lzptr/solar-controller/enclosure/renders/cutaway.png

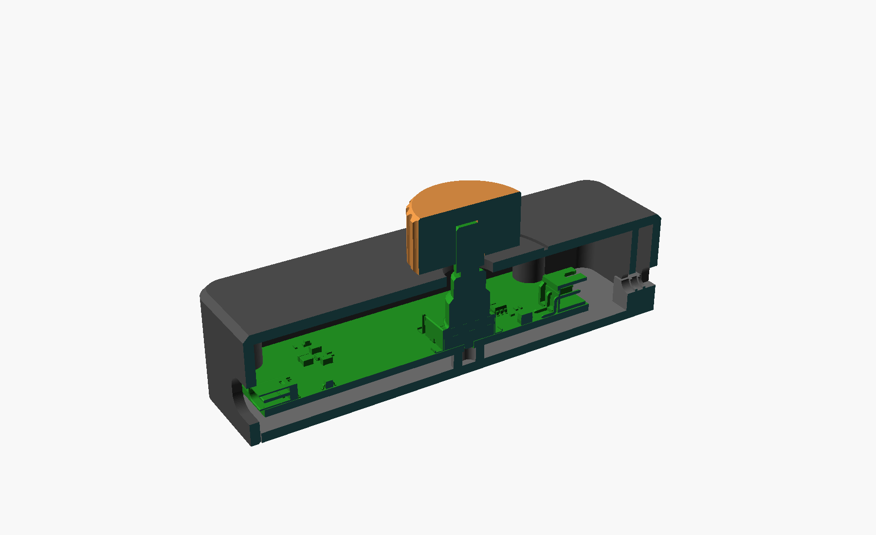
enclosure/renders/cutaway.png
