lzptr/solar-controller/enclosure/renders/exploded.png

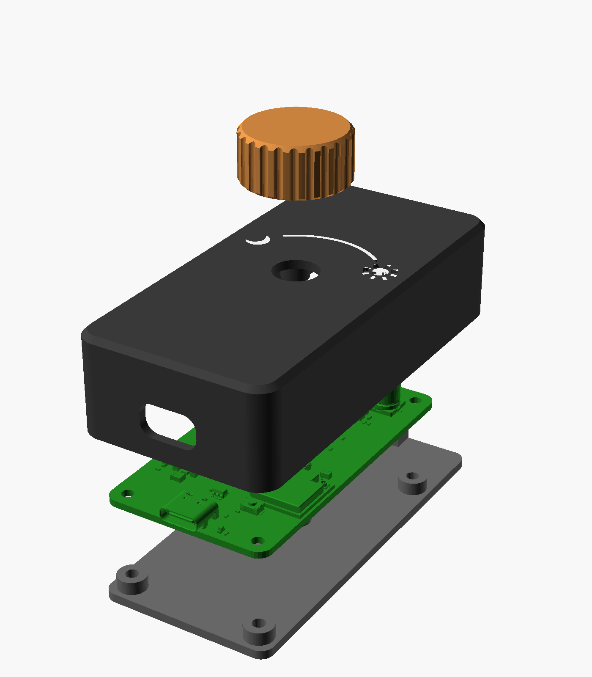
enclosure/renders/exploded.png
