lzptr/solar-controller/enclosure/renders/h103_post_neck.png

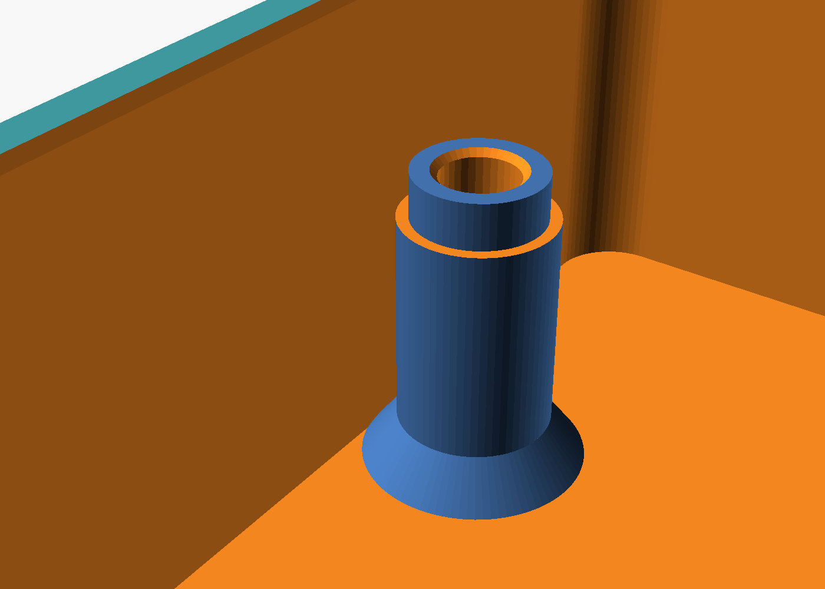
enclosure/renders/h103_post_neck.png
