lzptr/solar-controller/enclosure/renders/lid_top.png

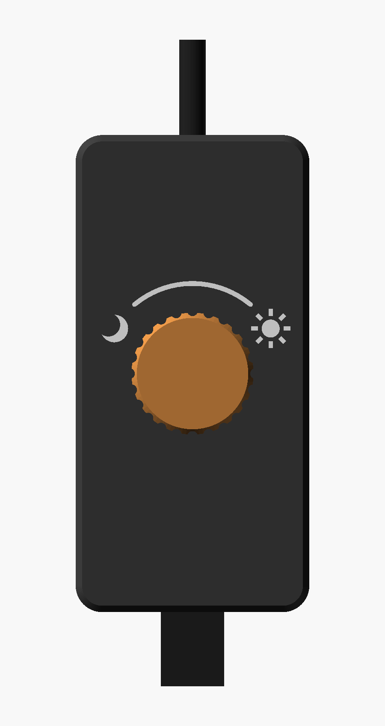
enclosure/renders/lid_top.png
