lzptr/solar-controller/globe_socket/renders/cutaway_iso.png

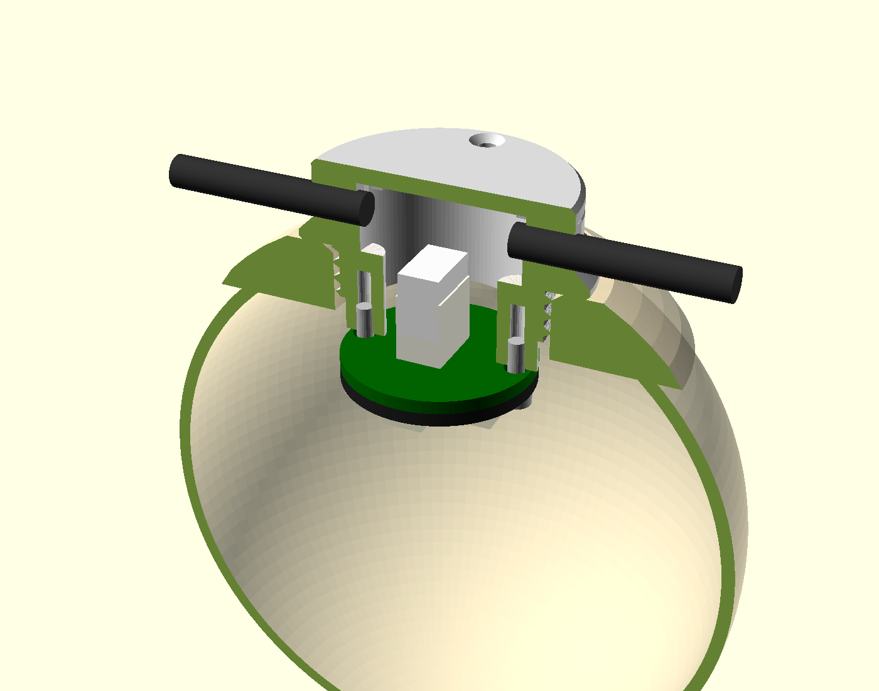
globe_socket/renders/cutaway_iso.png
