lzptr/solar-controller/globe_socket/renders/exploded.png

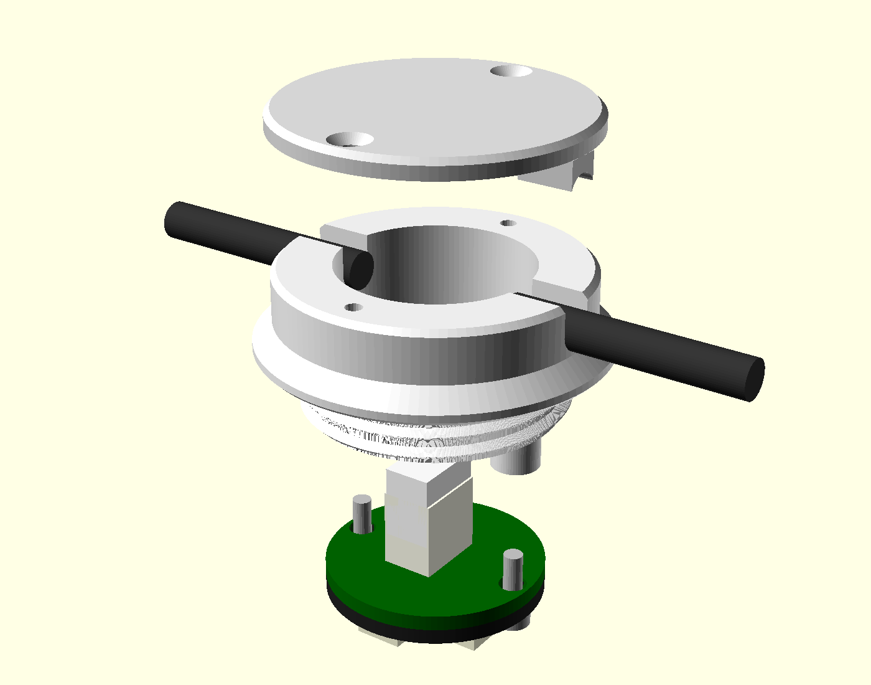
globe_socket/renders/exploded.png
