lzptr/solar-controller/hardware/led_adapter/renders/bottom.png

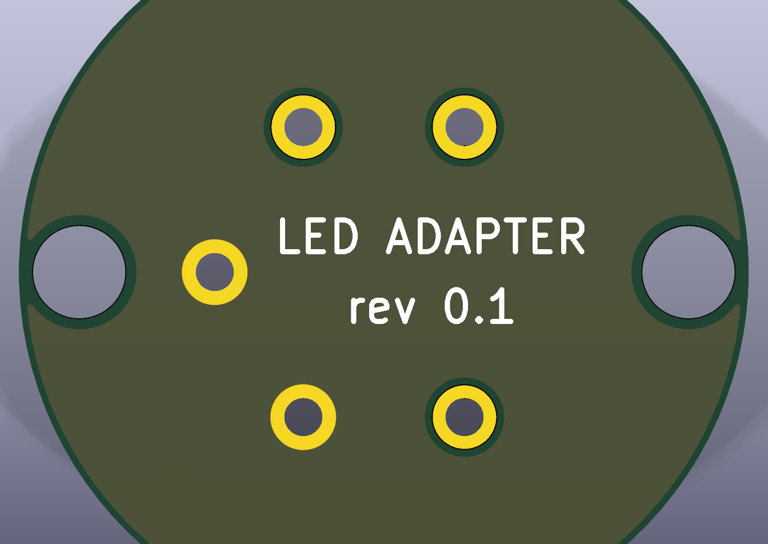
hardware/led_adapter/renders/bottom.png
