lzptr/solar-controller/hardware/led_adapter/renders/top.png

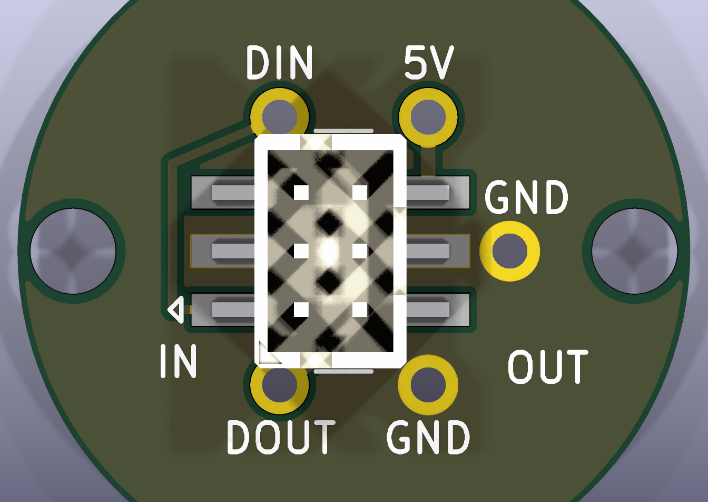
hardware/led_adapter/renders/top.png
