lzptr/solar-controller/hardware/solar_controller/renders/bottom.png

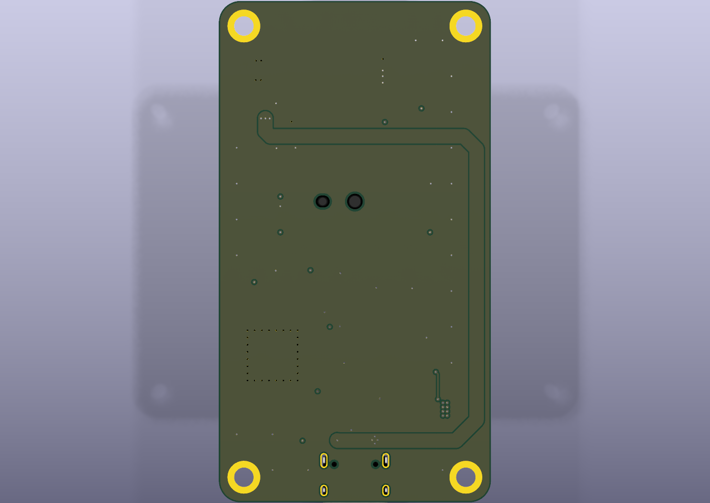
hardware/solar_controller/renders/bottom.png
