lzptr/solar-controller/hardware/solar_controller/renders/top.png

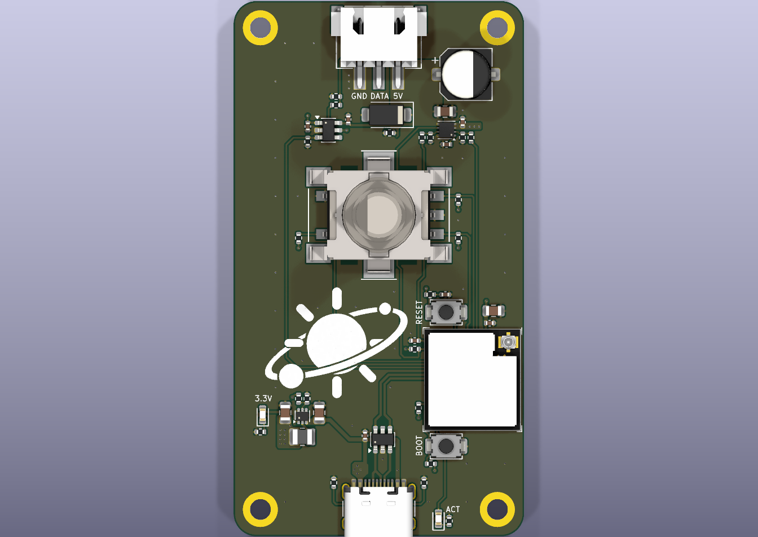
hardware/solar_controller/renders/top.png
