lzptr/solar-controller/hardware/production/bom.csv

Designator | Footprint | Quantity | Value | LCSC Part #
C205 | 0805 | 1 | 4u7 | C1779
C206, C303, C405 | 0805 | 3 | 22u | C45783
C301 | 0402 | 1 | 1u | C14445
C302, C304, C401, C402, C403, C407, C408 | 0402 | 7 | 100n | C1525
C404 | CP_Elec_6.3x7.7 | 1 | 470u | C46550459
D201 | 0603 | 1 | LED_GREEN | C965804
D301 | 0603 | 1 | LED_ACT | C965804
D401 | D_SMA | 1 | SS34 | C8678
J301 | USB_C_Receptacle_HRO_TYPE-C-31-M-12 | 1 | USB_C_Receptacle_USB2.0 | C165948
J401 | Megastar_ZX-XH2.54-3PWT | 1 | ZX-XH2.54-3PWT | C7429672
L201 | 1008 | 1 | 1u | C435392
R208, R407, R410, R414 | 0402 | 4 | 100k | C25741
R209 | 0402 | 1 | 22k | C25768
R211, R306, R405, R406, R411, R412 | 0402 | 6 | 2k2 | C25879
R301, R302, R303, R404, R408, R413 | 0402 | 6 | 10k | C25744
R307, R308 | 0402 | 2 | 5k1 | C25905
R403 | 0402 | 1 | 1k | C11702
R409 | 0402 | 1 | 330 | C25104
SW301 | SW_SPST_TS-1088-xR020 | 1 | RESET | C720477
SW302 | SW_SPST_TS-1088-xR020 | 1 | BOOT | C720477
SW402 | ALPS_EC11J1525402 | 1 | EC11J1525402 | C209762
U203 | SOT-563 | 1 | TPS62A01ADRL | C5181455
U301 | ESP32-C6-MINI-1U | 1 | ESP32-C6-MINI-1U-H4 | C20627095
U302 | SOT-23-6 | 1 | USBLC6-2SC6 | C5261088
U402 | Texas_DSG0008A_WSON-8-1EP_2x2mm_P0.5mm_EP0.9x1.6mm | 1 | TPS259531DSGR | C2155674
U403 | SOT-23-6 | 1 | SN74LVC1T45DBVR | C7843
