lzptr/solar-controller/hardware/led_adapter/production/bom.csv

Designator | Footprint | Quantity | Value | LCSC Part #
J1 | Hanxia_HX-PHD2.0-2x3ALT | 1 | HX-PHD2.0-2x3ALT | C53055815
