lzptr/solar-controller/enclosure/ref/assembly_check.3mf

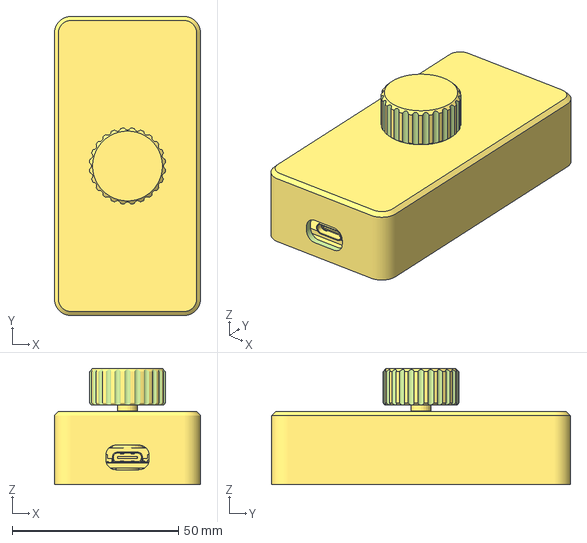
[picture p12: CAD file, 2026-10-16]
enclosure/ref/assembly_check.3mf
44.0 x 90.0 x 35.0 mm
