lzptr/solar-controller/enclosure/ref/pcb.stl

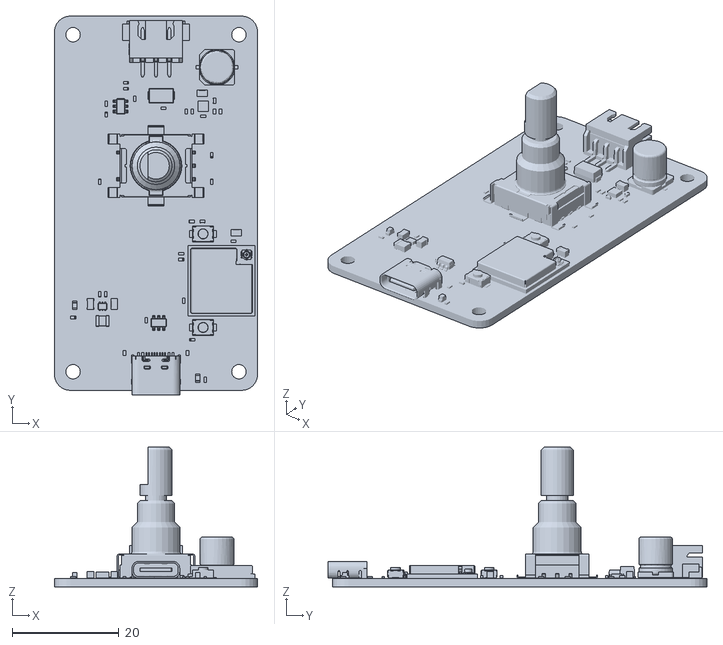
[picture p13: CAD file, 2026-10-16]
enclosure/ref/pcb.stl
38.0 x 70.8 x 26.1
