lzptr/solar-controller/enclosure/solar_controller_enclosure.3mf

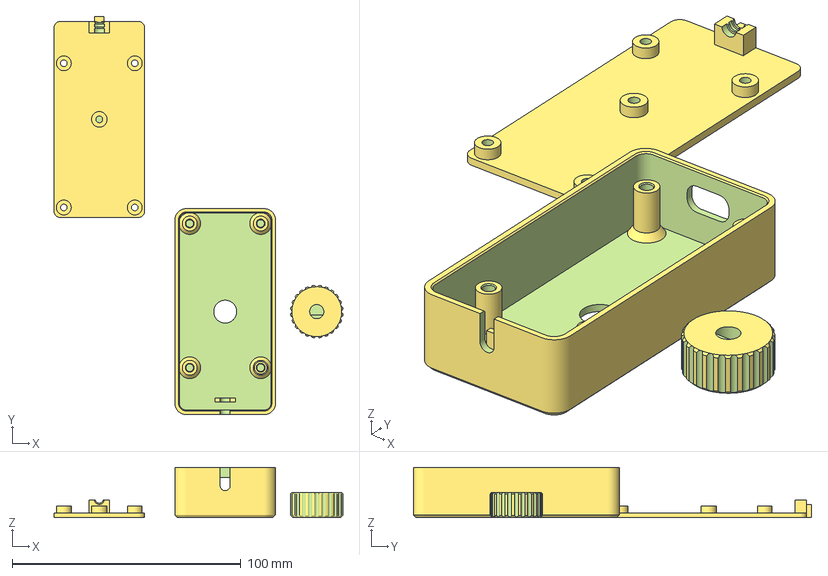
[picture p14: CAD file, 2026-10-16]
enclosure/solar_controller_enclosure.3mf
126.3 x 174.0 x 22.0 mm
base_plate
top_shell
knob
