lzptr/solar-controller/enclosure/stl/knob.stl

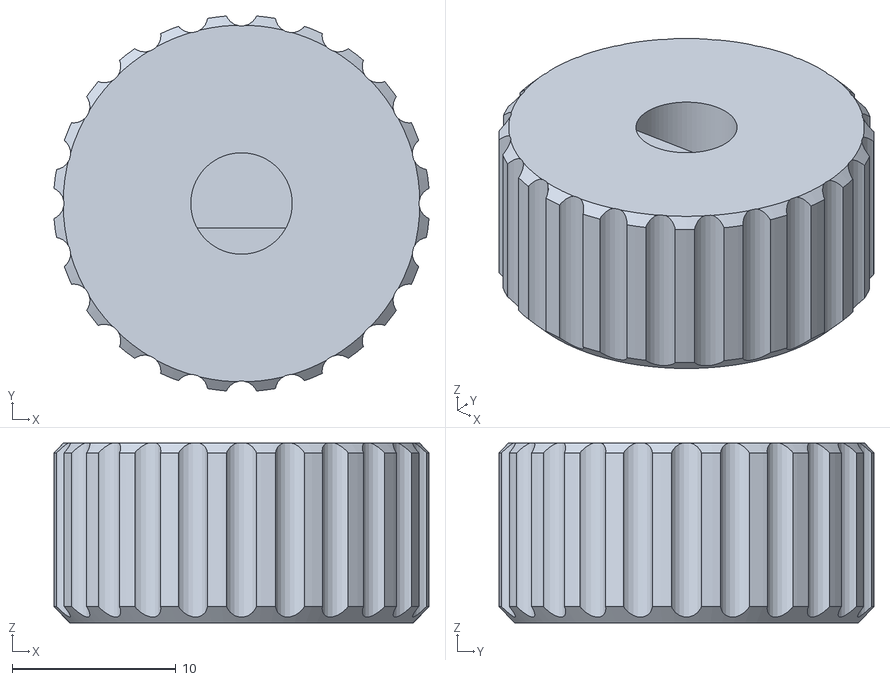
[picture p15: CAD file, 2026-10-16]
enclosure/stl/knob.stl
22.9 x 22.9 x 11.0
