lzptr/solar-controller/globe_socket/stl/socket_body.stl

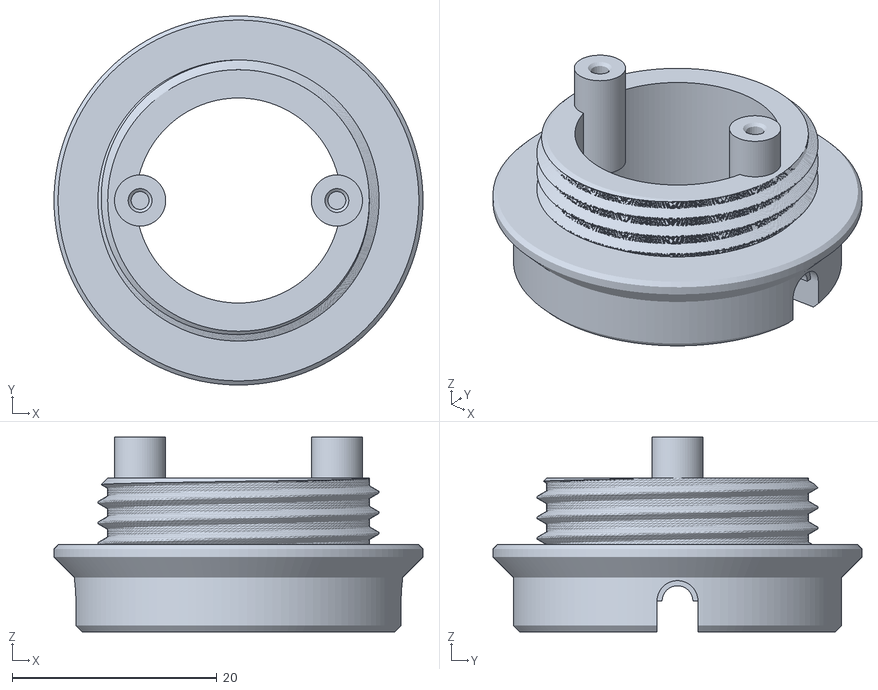
[picture p16: CAD file, 2026-10-22]
globe_socket/stl/socket_body.stl
36.0 x 36.0 x 19.0
