lzptr/solar-controller/enclosure/stl/base_plate.stl

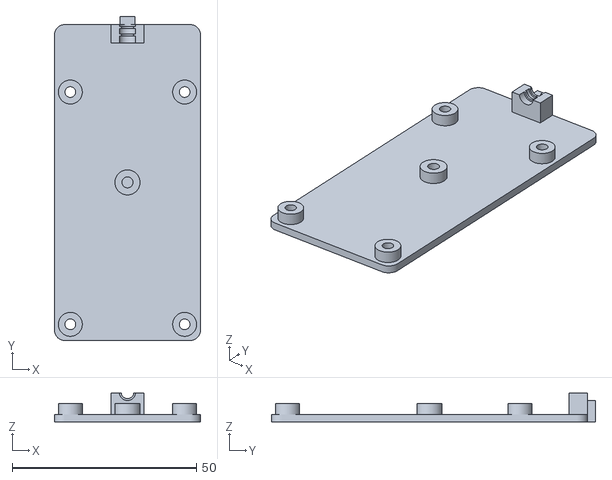
[picture p17: CAD file, 2026-10-16]
enclosure/stl/base_plate.stl
39.6 x 87.9 x 7.80
