lzptr/solar-controller/globe_socket/stl/socket_cap.stl

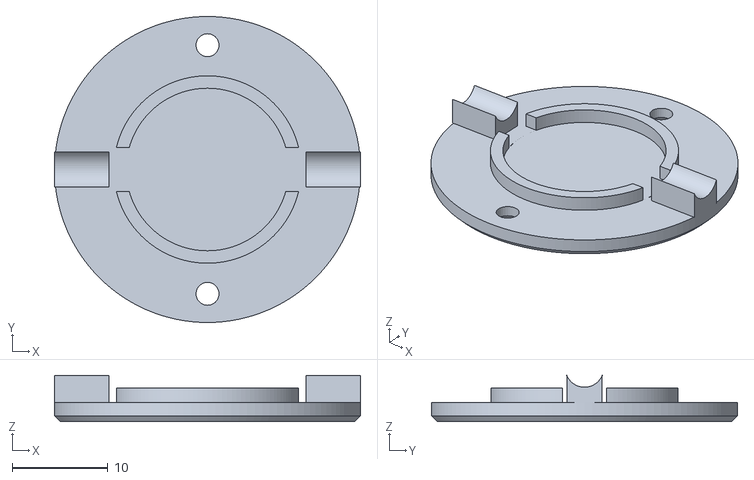
[picture p18: CAD file, 2026-10-22]
globe_socket/stl/socket_cap.stl
32.0 x 32.0 x 4.84
