lzptr/solar-controller/enclosure/stl/artwork_inlay.stl

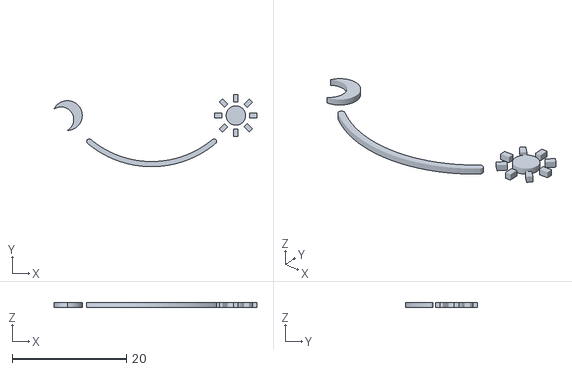
[picture p19: CAD file, 2026-10-16]
enclosure/stl/artwork_inlay.stl
35.5 x 12.6 x 0.8
