lzptr/solar-controller/enclosure/stl/top_shell.stl

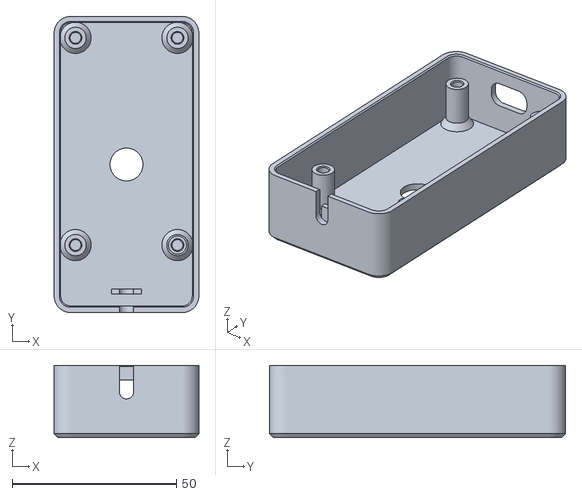
[picture p20: CAD file, 2026-10-16]
enclosure/stl/top_shell.stl
44.0 x 90.0 x 22.0
