lzptr/solar-controller/enclosure/renders/print_layout.png

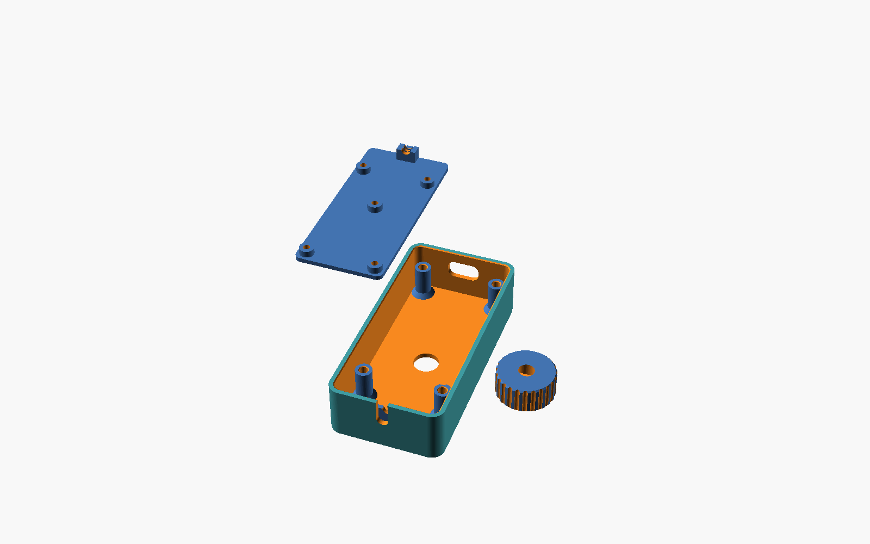
enclosure/renders/print_layout.png
