lzptr/solar-controller/globe_socket/renders/print_layout.png

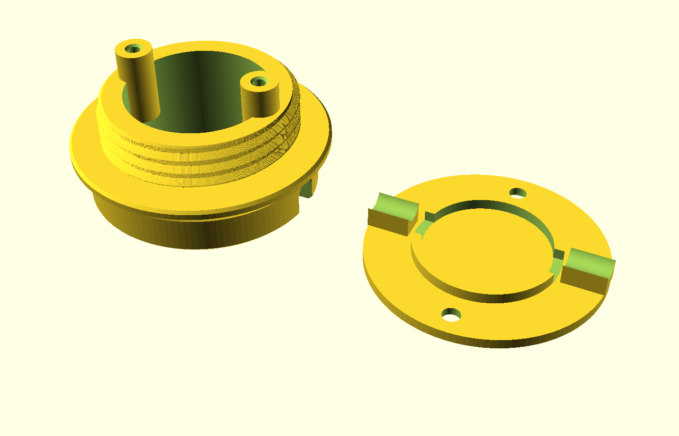
globe_socket/renders/print_layout.png
