lzptr/solar-controller/hardware/solar-controller.kicad_pcb

## KiCad design hardware/solar-controller.kicad_pcb (2026-10-15)

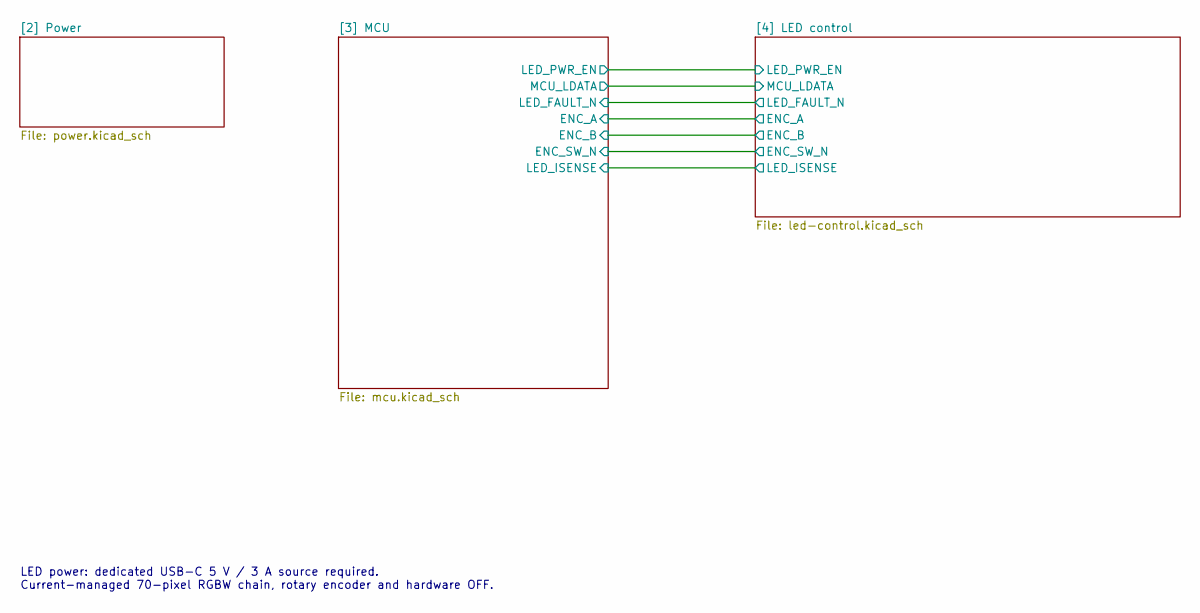
[picture p23: schematic solar-controller.kicad_sch, LED power and controls]

Notes on the sheet:
LED power: dedicated USB-C 5 V / 3 A source required. Current-managed 70-pixel RGBW chain, rotary encoder and hardware OFF.

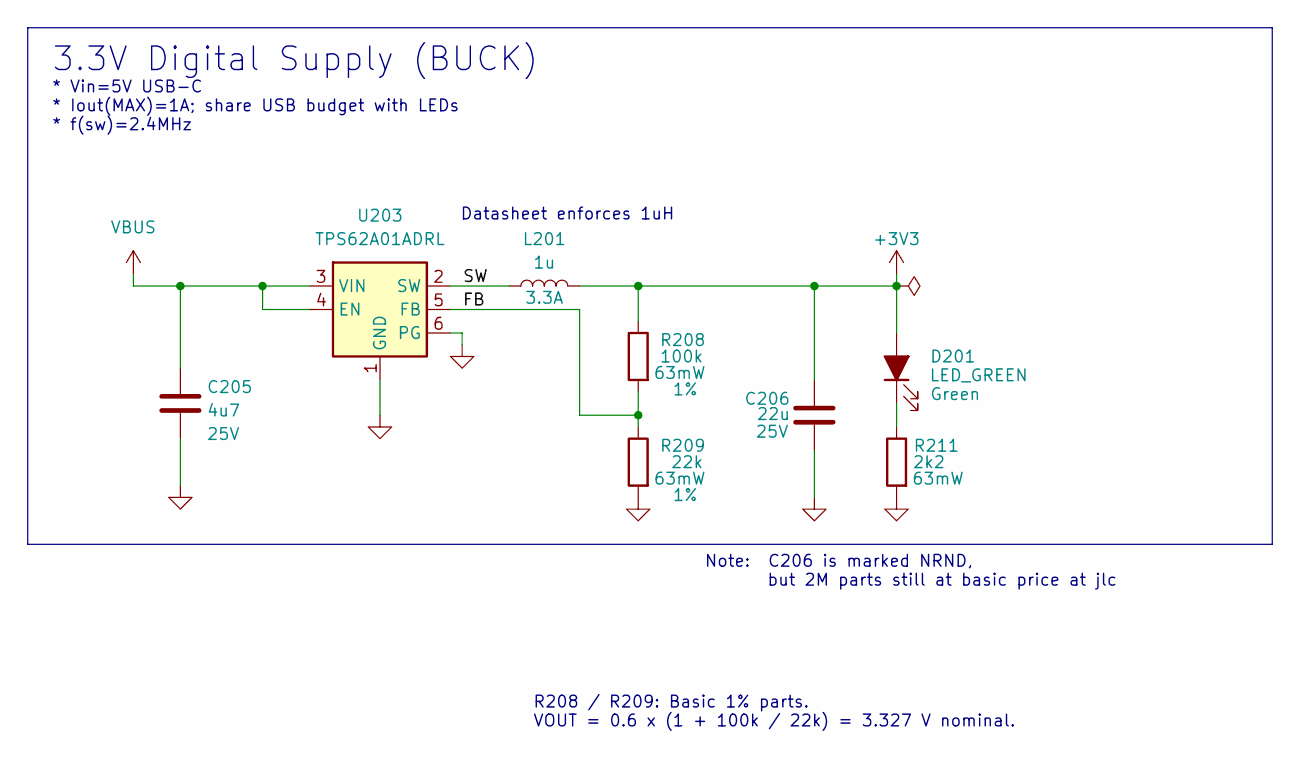
[picture p24: schematic power.kicad_sch, LED power and controls]

Parts:
C205: 4u7; C_0805_2012Metric; Rating 25V; LCSC Part # C1779
C206: 22u; C_0805_2012Metric; Rating 25V; LCSC Part # C45783
D201: LED_GREEN; LED_0603_1608Metric; Rating Green; LCSC Part # C965804
L201: 1u; L_1008_2520Metric; Rating 3.3A; LCSC Part # C435392
R208: 100k; R_0402_1005Metric; Rating 63mW; LCSC Part # C25741
R209: 22k; R_0402_1005Metric; Rating 63mW; LCSC Part # C25768
R211: 2k2; R_0402_1005Metric; Rating 63mW; LCSC Part # C25879
U203: TPS62A01ADRL; SOT-563; LCSC Part # C5181455

Connections:
+3V3: C206.1, D201.2 (A), L201.2, R208.1; also elsewhere on the board
/[2] Power/FB: R208.2, R209.1, U203.5 (FB)
/[2] Power/SW: L201.1, U203.2 (SW)
GND: C205.2, C206.2, R209.2, R211.2, U203.1 (GND), U203.6 (PG); also elsewhere on the board
unnamed: D201.1 (K), R211.1
VBUS: C205.1, U203.3 (VIN), U203.4 (EN); also elsewhere on the board

Notes on the sheet:
* Vin=5V USB-C * Iout(MAX)=1A; share USB budget with LEDs * f(sw)=2.4MHz
Datasheet enforces 1uH
Note: C206 is marked NRND, but 2M parts still at basic price at jlc
3.3V Digital Supply (BUCK)
R208 / R209: Basic 1% parts. VOUT = 0.6 x (1 + 100k / 22k) = 3.327 V nominal.

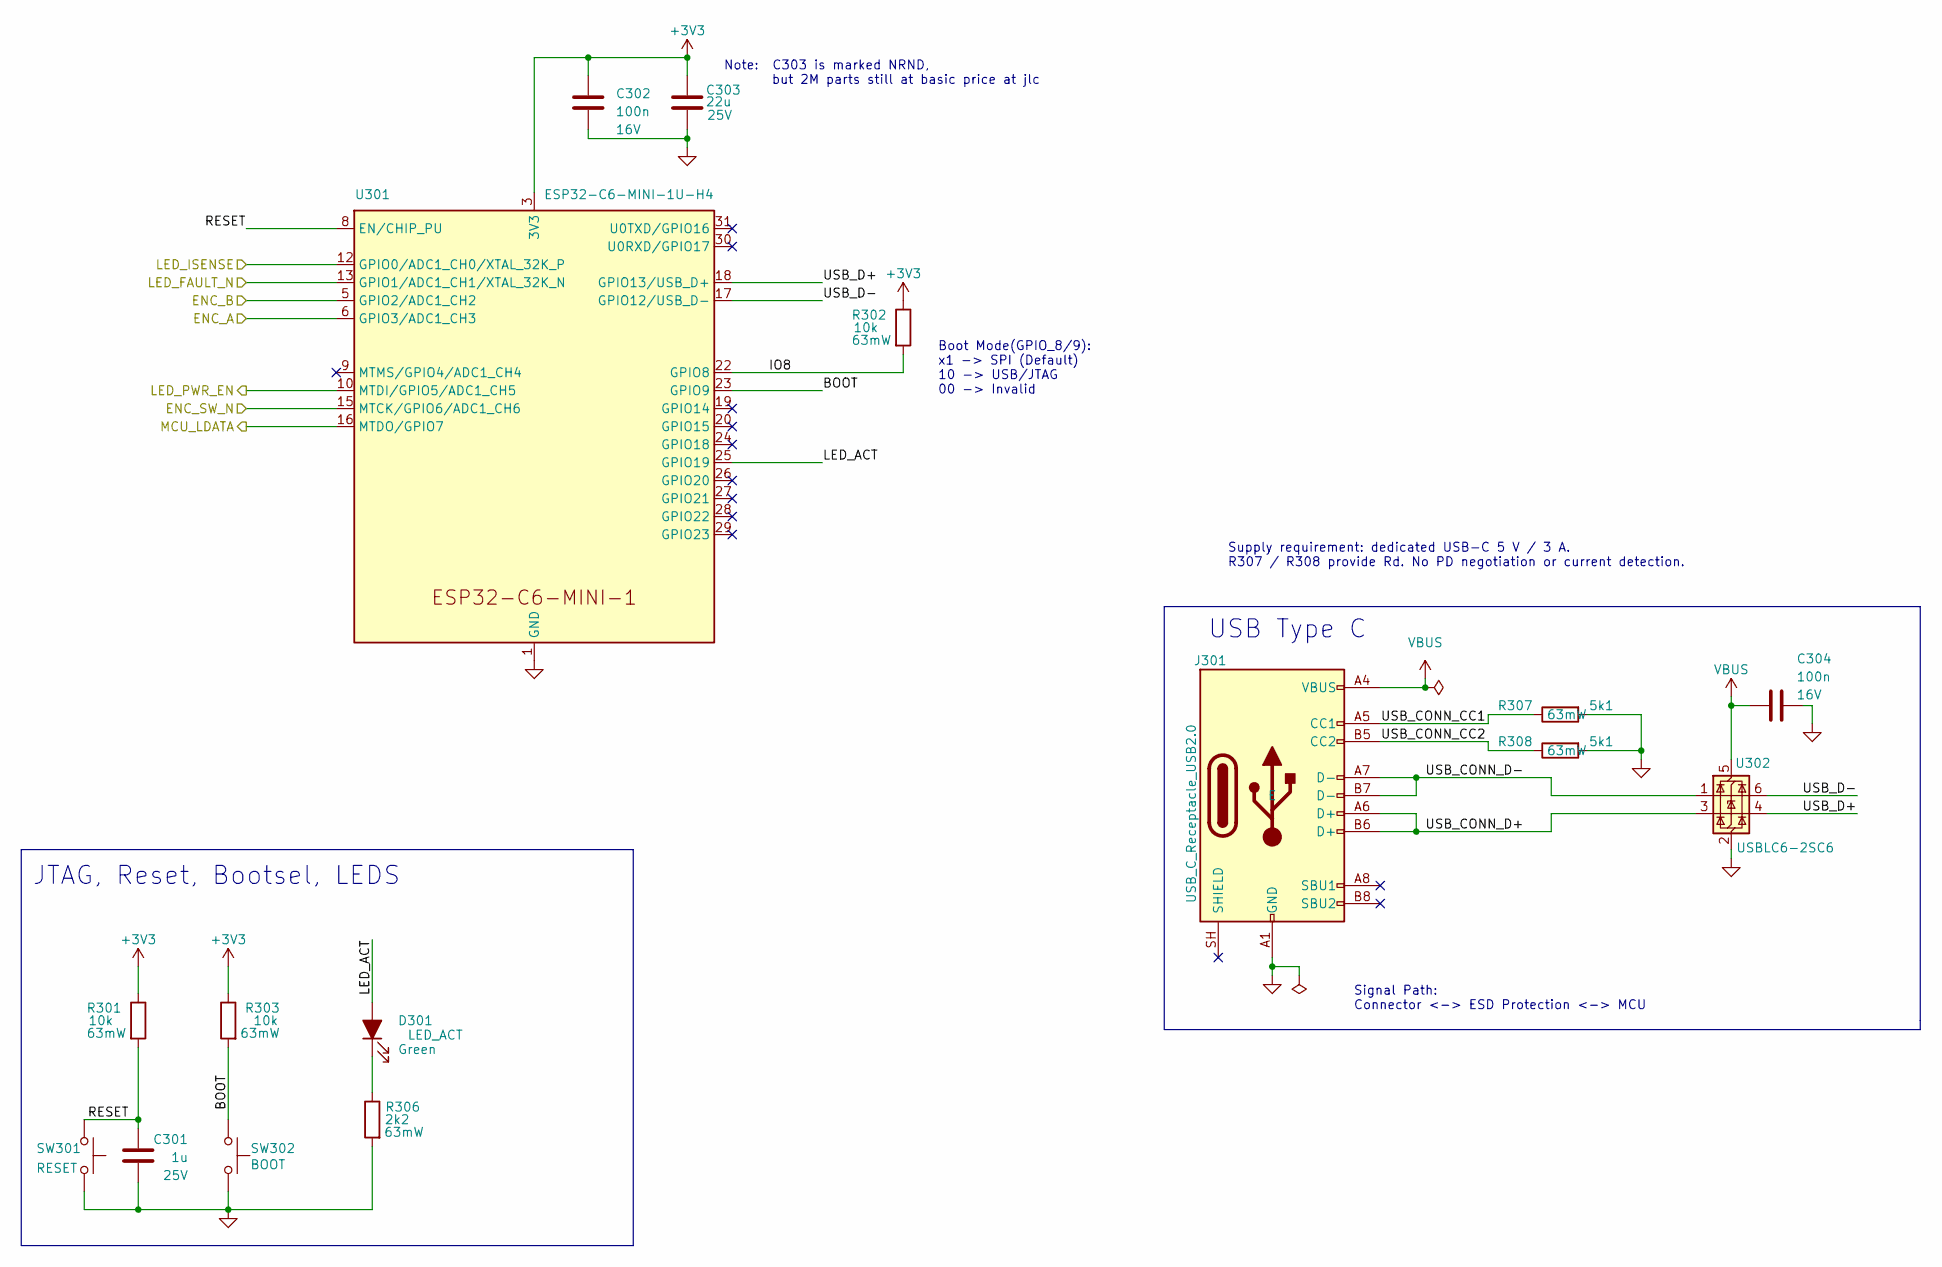
[picture p25: schematic mcu.kicad_sch, LED power and controls]

Parts:
C301: 1u; C_0402_1005Metric; Rating 25V; LCSC Part # C52923
C302, C304: 100n; C_0402_1005Metric; Rating 16V; LCSC Part # C1525
C303: 22u; C_0805_2012Metric; Rating 25V; LCSC Part # C45783
D301: LED_ACT; LED_0603_1608Metric; Rating Green; LCSC Part # C2994781
J301: USB_C_Receptacle_USB2.0; USB_C_Receptacle_HRO_TYPE-C-31-M-12; LCSC Part # C165948
R301, R302, R303: 10k; R_0402_1005Metric; Rating 63mW; LCSC Part # C25744
R306: 2k2; R_0402_1005Metric; Rating 63mW; LCSC Part # C25879
R307, R308: 5k1; R_0402_1005Metric; Rating 63mW; LCSC Part # C25905
SW301: RESET; SW_SPST_TS-1088-xR020; LCSC Part # C720477
SW302: BOOT; SW_SPST_TS-1088-xR020; LCSC Part # C720477
U301: ESP32-C6-MINI-1U-H4; ESP32-C6-MINI-1U; LCSC Part # C20627095
U302: USBLC6-2SC6; SOT-23-6; LCSC Part # C5261088

Connections:
+3V3: C302.1, C303.1, R301.1, R302.1, R303.1, U301.3 (3V3); also elsewhere on the board
/[3] MCU/BOOT: R303.2, SW302.1, U301.23 (GPIO9)
/[3] MCU/ENC_A: U301.6 (GPIO3/ADC1_CH3); also elsewhere on the board
/[3] MCU/ENC_B: U301.5 (GPIO2/ADC1_CH2); also elsewhere on the board
/[3] MCU/ENC_SW_N: U301.15 (MTCK/GPIO6/ADC1_CH6); also elsewhere on the board
/[3] MCU/IO8: R302.2, U301.22 (GPIO8)
/[3] MCU/LED_ACT: D301.2 (A), U301.25 (GPIO19)
/[3] MCU/LED_FAULT_N: U301.13 (GPIO1/ADC1_CH1/XTAL_32K_N); also elsewhere on the board
/[3] MCU/LED_ISENSE: U301.12 (GPIO0/ADC1_CH0/XTAL_32K_P); also elsewhere on the board
/[3] MCU/LED_PWR_EN: U301.10 (MTDI/GPIO5/ADC1_CH5); also elsewhere on the board
/[3] MCU/MCU_LDATA: U301.16 (MTDO/GPIO7); also elsewhere on the board
/[3] MCU/RESET: C301.1, R301.2, SW301.1, U301.8 (EN/CHIP_PU)
/[3] MCU/USB_CONN_CC1: J301.A5 (CC1), R307.1
/[3] MCU/USB_CONN_CC2: J301.B5 (CC2), R308.1
/[3] MCU/USB_CONN_D+: J301.A6 (D+), J301.B6 (D+), U302.3 (I/O2)
/[3] MCU/USB_CONN_D-: J301.A7 (D-), J301.B7 (D-), U302.1 (I/O1)
/[3] MCU/USB_D+: U301.18 (GPIO13/USB_D+), U302.4 (I/O2)
/[3] MCU/USB_D-: U301.17 (GPIO12/USB_D-), U302.6 (I/O1)
GND: C301.2, C302.2, C303.2, C304.2, J301.A1 (GND), J301.A12 (GND), J301.B1 (GND), J301.B12 (GND), R306.2, R307.2, R308.2, SW301.2, SW302.2, U301.1 (GND), U301.2 (GND), U301.11 (GND), U301.14 (GND), U301.36 (GND), U301.37 (GND), U301.38 (GND), U301.39 (GND), U301.40 (GND), U301.41 (GND), U301.42 (GND), U301.43 (GND), U301.44 (GND), U301.45 (GND), U301.46 (GND), U301.47 (GND), U301.48 (GND), U301.49 (GND), U301.50 (GND), U301.51 (GND), U301.52 (GND), U301.53 (GND), U302.2 (GND); also elsewhere on the board
unnamed: D301.1 (K), R306.1
VBUS: C304.1, J301.A4 (VBUS), J301.A9 (VBUS), J301.B4 (VBUS), J301.B9 (VBUS), U302.5 (VBUS); also elsewhere on the board

Notes on the sheet:
Signal Path: Connector <-> ESD Protection <-> MCU
Note: C303 is marked NRND, but 2M parts still at basic price at jlc
Boot Mode(GPIO_8/9): x1 -> SPI (Default) 10 -> USB/JTAG 00 -> Invalid
USB Type C
Supply requirement: dedicated USB-C 5 V / 3 A. R307 / R308 provide Rd. No PD negotiation or current detection.
JTAG, Reset, Bootsel, LEDS

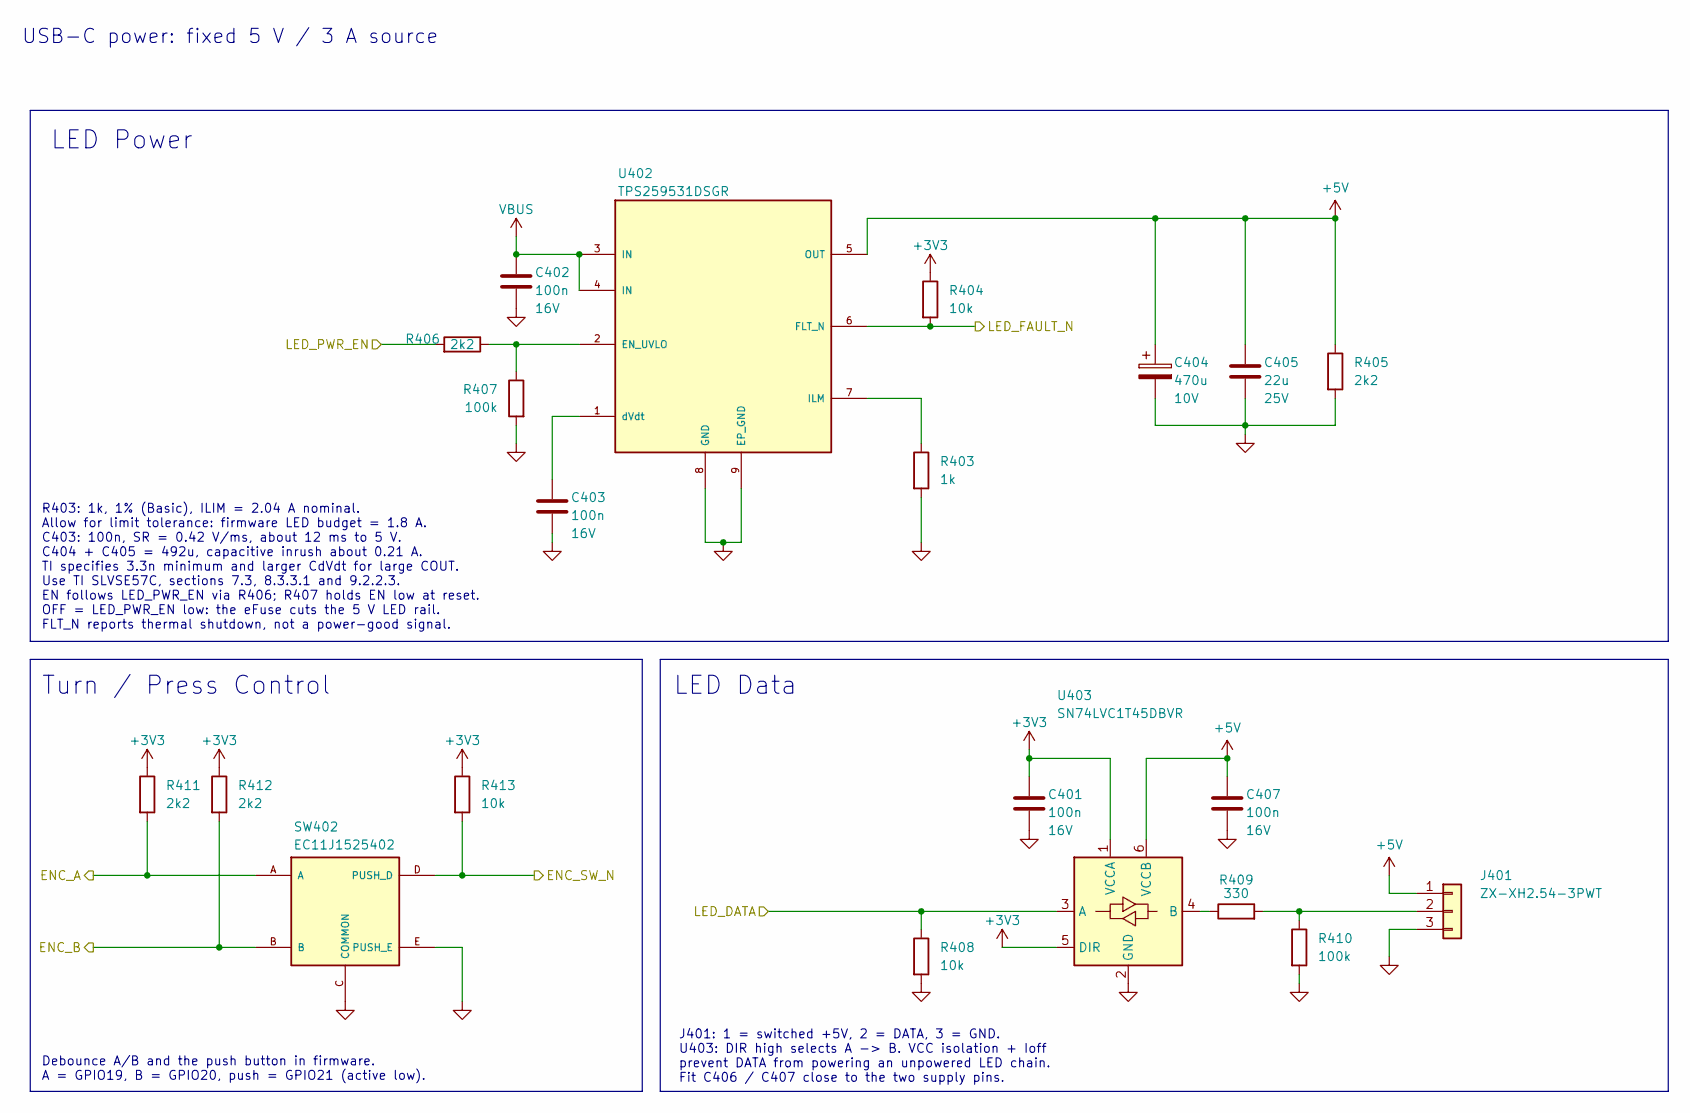
[picture p26: schematic led-control.kicad_sch, LED power and controls]

Parts:
C401, C402, C403, C407: 100n; C_0402_1005Metric; Rating 16V; LCSC Part # C1525
C404: 470u; CP_Elec_6.3x7.7; Rating 10V; MPN MA10V470M6X8; LCSC Part # C46550459
C405: 22u; C_0805_2012Metric; Rating 25V; LCSC Part # C45783
J401: ZX-XH2.54-3PWT; Megastar_ZX-XH2.54-3PWT; Rating 3A / contact; MPN ZX-XH2.54-3PWT; LCSC Part # C7429672
R403: 1k; R_0402_1005Metric; Rating 62.5mW; MPN 0402WGF1001TCE; LCSC Part # C11702
R404, R408, R413: 10k; R_0402_1005Metric; Rating 63mW; LCSC Part # C25744
R405, R406, R411, R412: 2k2; R_0402_1005Metric; Rating 63mW; LCSC Part # C25879
R407, R410: 100k; R_0402_1005Metric; Rating 63mW; LCSC Part # C25741
R409: 330; R_0402_1005Metric; Rating 63mW; LCSC Part # C25104
SW402: EC11J1525402; ALPS_EC11J1525402; Rating 10mA / 5V; LCSC Part # C209762
U402: TPS259531DSGR; Texas_DSG0008A_WSON-8-1EP_2x2mm_P0.5mm_EP0.9x1.6mm; Rating 5V branch / 2.04A nominal; LCSC Part # C2155674
U403: SN74LVC1T45DBVR; SOT-23-6; Rating 3.3V -> switched 5V; LCSC Part # C7843

Connections:
+3V3: C401.1, R404.1, R411.1, R412.1, R413.1, U403.1 (VCCA), U403.5 (DIR); also elsewhere on the board
+5V: C404.1, C405.1, C407.1, J401.1, R405.1, U402.5 (OUT), U403.6 (VCCB); also elsewhere on the board
/[3] MCU/ENC_A: R411.2, SW402.A; also elsewhere on the board
/[3] MCU/ENC_B: R412.2, SW402.B; also elsewhere on the board
/[3] MCU/ENC_SW_N: R413.2, SW402.D (PUSH_D); also elsewhere on the board
/[3] MCU/LED_FAULT_N: R404.2, U402.6 (FLT_N); also elsewhere on the board
/[3] MCU/LED_PWR_EN: R406.2; also elsewhere on the board
/[3] MCU/MCU_LDATA: R408.1, U403.3 (A); also elsewhere on the board
/[4] LED control/B_LDATA: R409.1, U403.4 (B)
/[4] LED control/CONN_LDATA: J401.2, R409.2, R410.1
/[4] LED control/EN_UVLO: R406.1, R407.1, U402.2 (EN_UVLO)
/[4] LED control/ILM: R403.1, U402.7 (ILM); also elsewhere on the board
/[4] LED control/dVdt: C403.1, U402.1 (dVdt)
GND: C401.2, C402.2, C403.2, C404.2, C405.2, C407.2, J401.3, R403.2, R405.2, R407.2, R408.2, R410.2, SW402.C (COMMON), SW402.E (PUSH_E), U402.8 (GND), U402.9 (EP_GND), U403.2 (GND); also elsewhere on the board
VBUS: C402.1, U402.3 (IN), U402.4 (IN); also elsewhere on the board

Notes on the sheet:
USB-C power: fixed 5 V / 3 A source
LED Data
R403: 1k, 1% (Basic), ILIM = 2.04 A nominal. Allow for limit tolerance: firmware LED budget = 1.8 A. C403: 100n, SR = 0.42 V/ms, about 12 ms to 5 V. C404 + C405 = 492u, capacitive inrush about 0.21 A. TI specifies 3.3n minimum and larger CdVdt for large COUT. Use TI SLVSE57C, sections 7.3, 8.3.3.1 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
LED Power
J401: 1 = switched +5V, 2 = DATA, 3 = GND. U403: DIR high selects A -> B. VCC isolation + Ioff prevent DATA from powering an unpowered LED chain. Fit C406 / C407 close to the two supply pins.
Turn / Press Control
Debounce A/B and the push button in firmware. A = GPIO19, B = GPIO20, push = GPIO21 (active low).

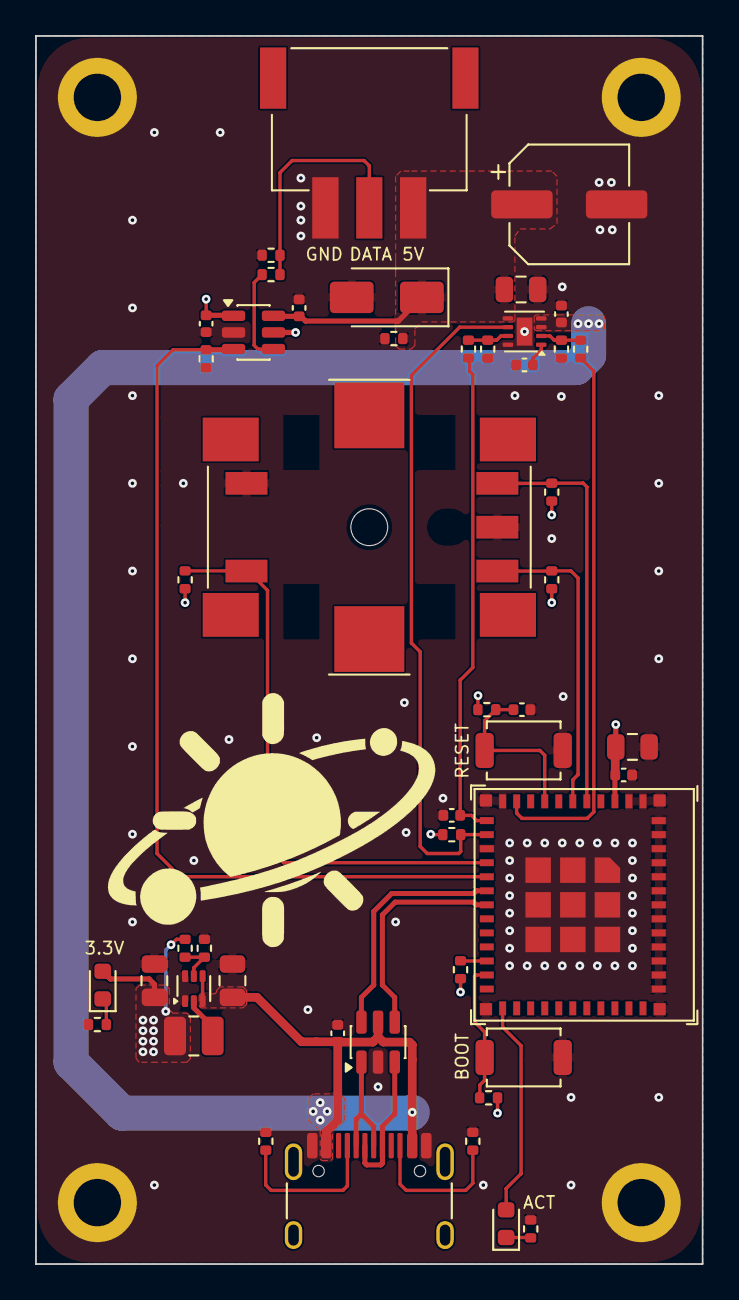
[picture p27: board solar-controller.kicad_pcb from above]

Board: 4 copper layers, 38.0 x 70.0 mm, 52 parts (0 on the bottom side), 30 nets.

Other parts of the board:
C408: 100n; C_0402_1005Metric
D401: SS34; D_SMA
H101, H102, H103, H104: GND; MountingHole_2.7mm_M2.5_ISO14580_Pad
R414: 100k; R_0402_1005Metric

Their connections:
+5V: D401.1 (K); also elsewhere on the board
/[3] MCU/LED_ISENSE: C408.1, R414.2; also elsewhere on the board
/[4] LED control/ILM: R414.1; also elsewhere on the board
GND: C408.2, D401.2 (A), H101.1 (1_1), H102.1 (1_1), H103.1 (1_1), H104.1 (1_1); also elsewhere on the board
