lzptr/solar-controller/(commit log)

2026-10-10 feat: Added led controller sheet
2026-10-10 feat: WIP pcb layout
2026-10-12 feat(firmware): Add SK6812 RGBW ring test firmware for the ESP32-C6 dev kit
    Minimal ESP-IDF v6.1 project for the Waveshare ESP32-C6-DEV-KIT-N8 that
    drives one 7-LED SK6812 RGBW ring on GPIO7 (matches MCU_LDATA on rev 0.1).
    - bsp: Kconfig-driven LED data GPIO and LED count
    - led_ring: per-LED RGBW state, linear global brightness, power-up white
    at 20 %, built on espressif/led_strip 3.0.3 (RMT)
    - led_cli: color/white/rgbw/pixel/bright/on/off/status commands on the
    USB Serial/JTAG console (follows UART0 if selected in menuconfig)
2026-10-14 fix(firmware): Stop reserving the LED data GPIO before the RMT driver
    ESP-IDF v6.x reserves a pin when gpio_config() sets it as an output, so
    the RMT TX channel created by led_strip logged "GPIO 7 is not usable,
    maybe conflict with others". The BSP now holds the data line low with
    the internal pull-down instead, leaving the pin for the RMT driver.
2026-10-15 Updated silkscreen and production files
2026-10-16 feat(enclosure): Add 3D-printed enclosure for rev 0.1
    Parametric OpenSCAD design for mounting the controller on the bed post:
    44 x 90 x 22 mm, thin base plate (flat back for VHB tape) inside a hollow
    top shell, PCB clamped by 4x M2.5x10 countersunk screws from the back into
    heat-set inserts in the lid posts.
    - USB-C opening in the bottom end wall, LED cable clamp at the top end
    - 23 mm fluted knob on the EC11J D-shaft, 2 mm above the lid
    - Moon/arc/sun artwork as a separate inlay part for a second filament
    - H103 post necked to clear C404
    - build.py regenerates stl/, the Bambu-ready 3MF and ref/assembly_check.3mf
    - ref/pcb.stl: KiCad export of the board with components for fit checks
    Also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
2026-10-22 refactor(hardware): Move the controller board into hardware/solar_controller
    Make room for the LED ring adapter as a second KiCad project next to it.
2026-10-22 feat(hardware): Add LED ring adapter PCB for the planet globes
    Small round board that sits back to back on the 23 mm SK6812 RGBW ring and
    gives it a keyed hanxia HX-PHD2.0-2x3ALT connector for the daisy-chained
    globe cables. Includes production files, renders and a simplified STEP model
    of the connector generated from the manufacturer drawing.
2026-10-22 feat(globe_socket): Add 3D-printed socket for the 75 mm lithophane globes
    Screws into the globe opening, holds the LED ring adapter stack and clamps
    the incoming and outgoing string cables so the cable carries the globe.
2026-10-22 docs(hardware): Add top and bottom renders of the solar controller board
2026-10-23 docs(hardware): Re-render both boards with the J1 connector model
    The LED adapter renders now show the hanxia PHD connector. Both boards use
    the same opaque background so the render sets match.
2026-11-07 feat(firmware): Add RGB LED strip variant in warm white (#2)
